Noah-Mav/alice-case/pcb/v3/right_outline.dxf

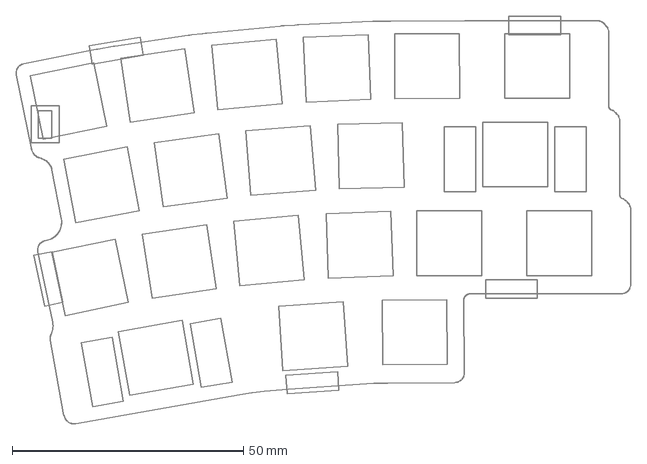
[picture p12: CAD file, 2026-11-01]
pcb/v3/right_outline.dxf
132.9 x 88.2 mm
