Noah-Mav/alice-case/prints/v3/case_body.stl

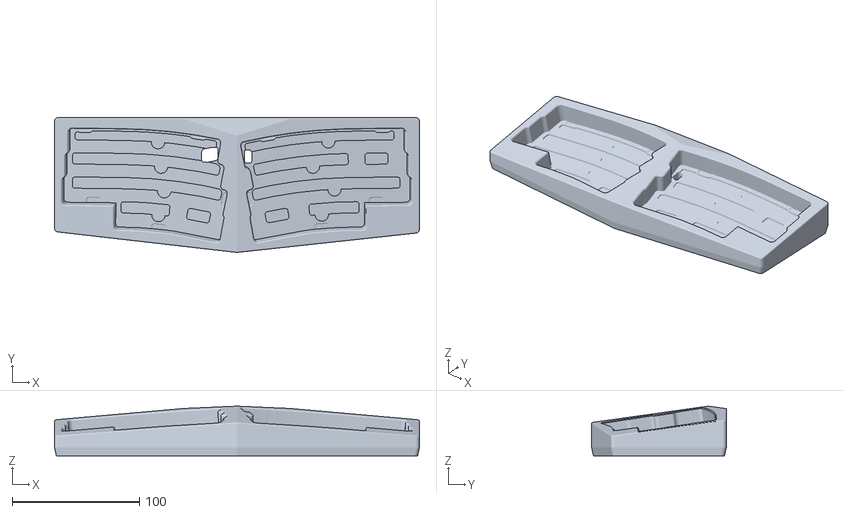
[picture p13: CAD file, 2026-11-01]
prints/v3/case_body.stl
286.5 x 105.9 x 39.1
