Noah-Mav/alice-case/pcb/v3/left_outline.dxf

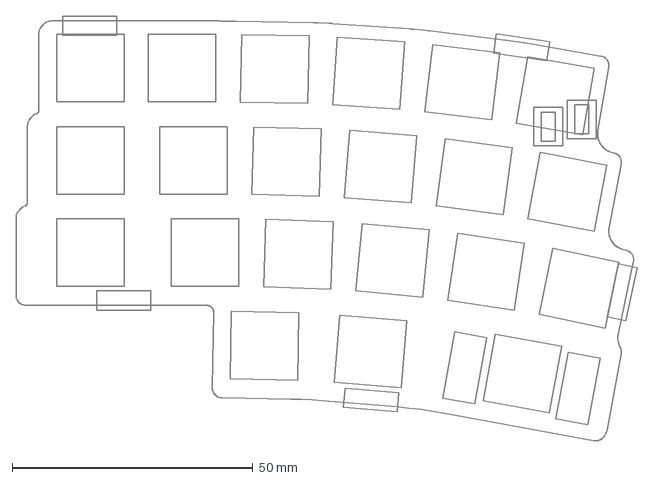
[picture p14: CAD file, 2026-11-01]
pcb/v3/left_outline.dxf
128.9 x 88.2 mm
