Noah-Mav/alice-case/prints/v3/dummy_pcb_right.stl

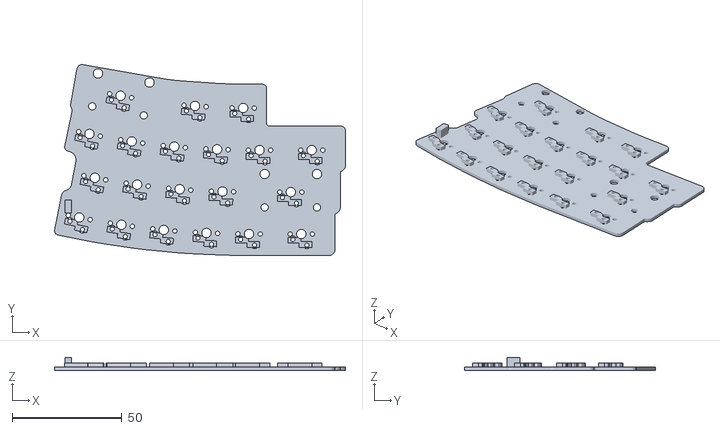
[picture p15: CAD file, 2026-11-01]
prints/v3/dummy_pcb_right.stl
132.9 x 87.2 x 5.85
