Noah-Mav/alice-case/prints/tpu_foot_x4.stl

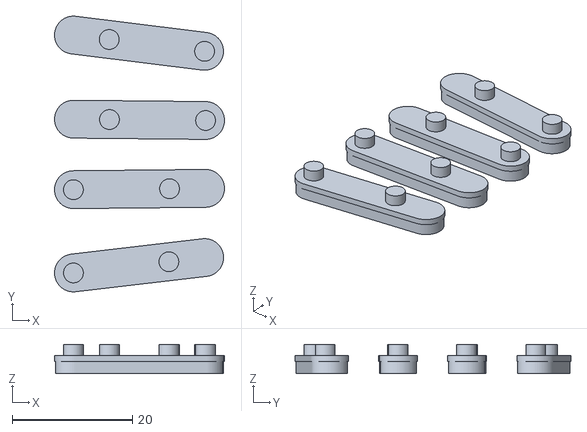
[picture p16: CAD file, 2026-10-18]
prints/tpu_foot_x4.stl
28.3 x 45.9 x 4.90
