Noah-Mav/alice-case/prints/v3/tpu_clip.stl

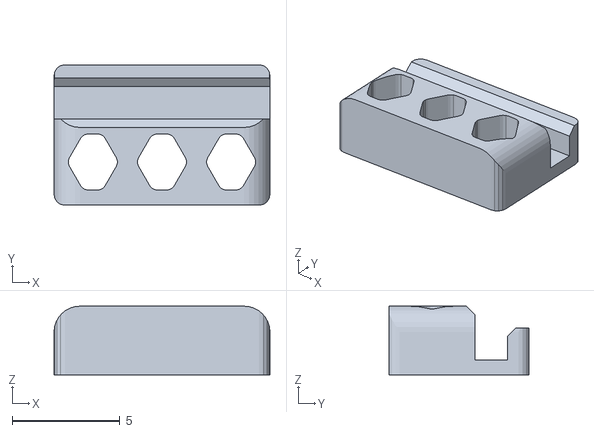
[picture p17: CAD file, 2026-11-01]
prints/v3/tpu_clip.stl
10.0 x 6.50 x 3.18
