Noah-Mav/alice-case/prints/tpu_pcbsnap_x8.stl

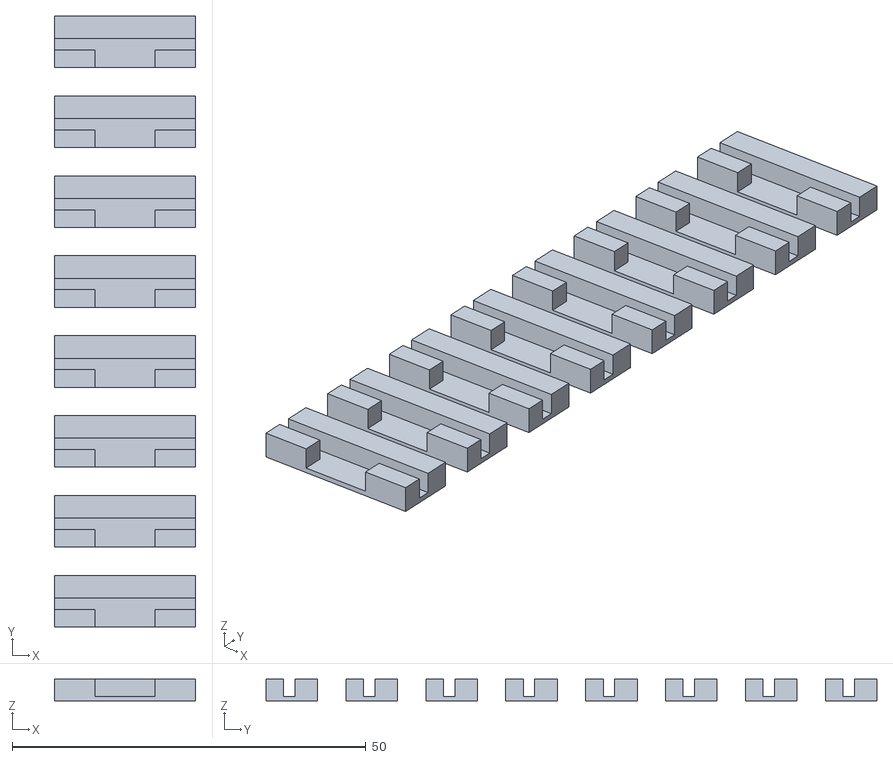
[picture p18: CAD file, 2026-10-18]
prints/tpu_pcbsnap_x8.stl
20.0 x 86.4 x 3.10
