Noah-Mav/alice-case/prints/v3/dummy_pcb_left.stl

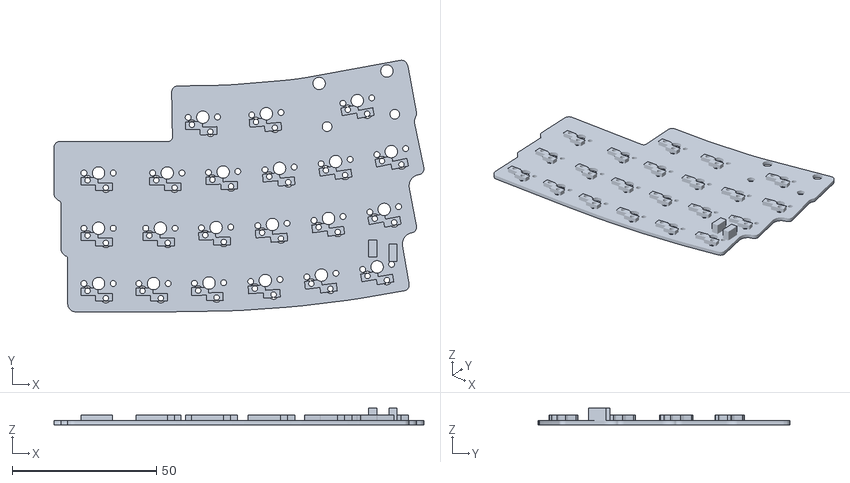
[picture p19: CAD file, 2026-11-01]
prints/v3/dummy_pcb_left.stl
128.2 x 87.2 x 5.85
