Noah-Mav/alice-case/prints/v3/tpu_clip_x10.stl

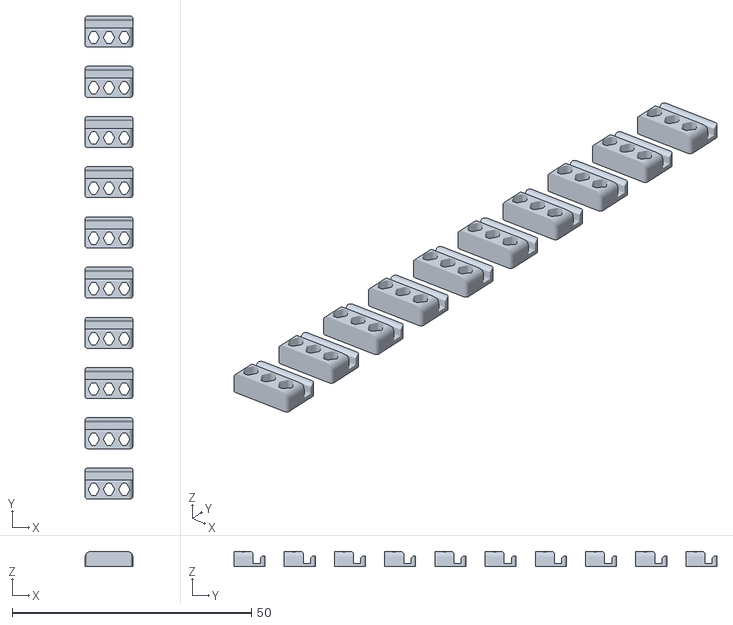
[picture p20: CAD file, 2026-11-01]
prints/v3/tpu_clip_x10.stl
10.0 x 101.0 x 3.18
