Noah-Mav/alice-case/prints/switch_fit_test.stl

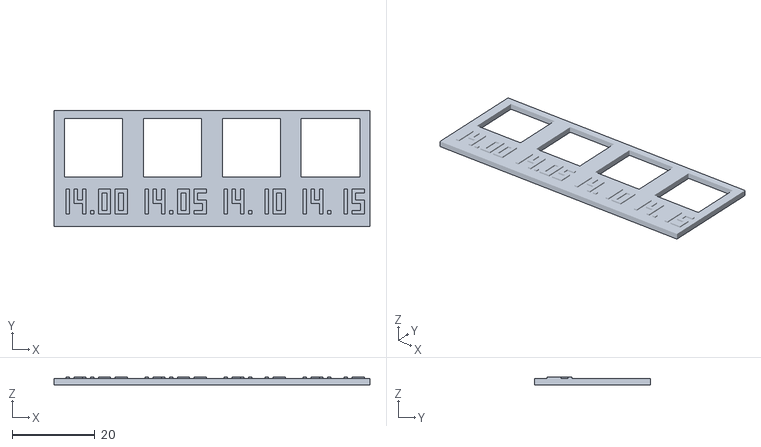
[picture p21: CAD file, 2026-10-18]
prints/switch_fit_test.stl
76.2 x 28.0 x 1.90
