Noah-Mav/alice-case/prints/v3/bottom_panel.stl

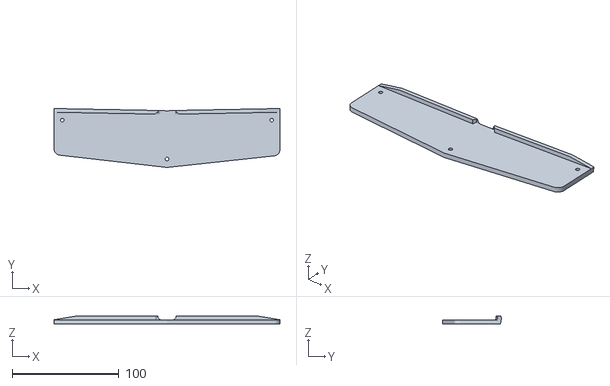
[picture p22: CAD file, 2026-10-31]
prints/v3/bottom_panel.stl
212.2 x 55.2 x 7.60
