Noah-Mav/alice-case/prints/v3/dummy_plate_right.stl

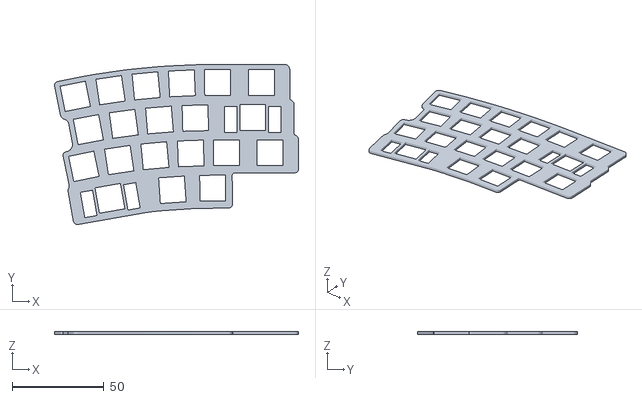
[picture p23: CAD file, 2026-10-31]
prints/v3/dummy_plate_right.stl
132.9 x 87.2 x 1.50
