Noah-Mav/alice-case/prints/dummy_pcb_left.stl

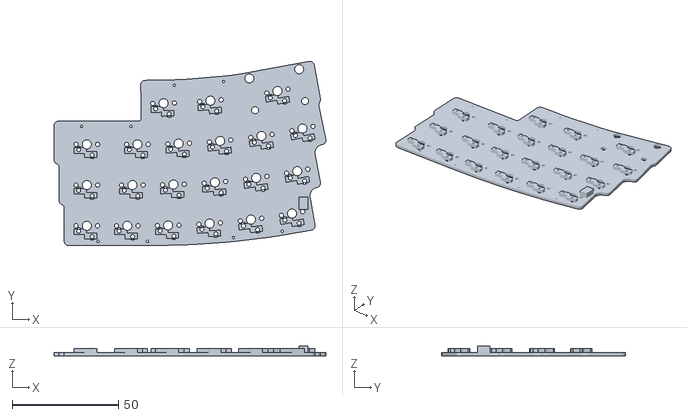
[picture p24: CAD file, 2026-10-18, an earlier design]
prints/dummy_pcb_left.stl
128.0 x 86.7 x 4.55
