Noah-Mav/alice-case/prints/v2/tpu_clip_front.stl

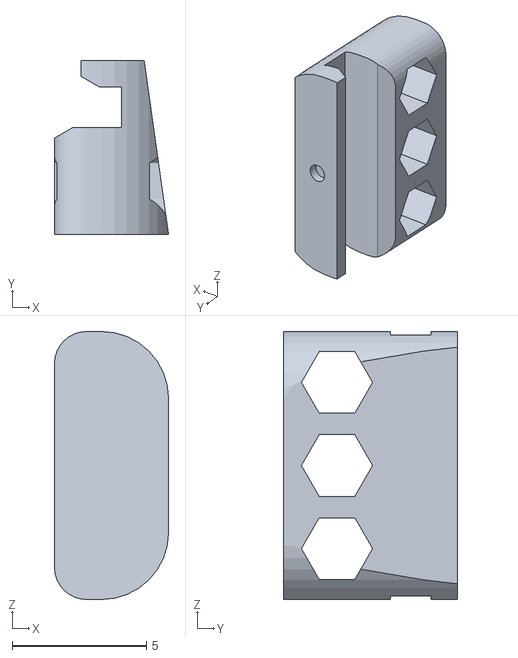
[picture p25: CAD file, 2026-10-24, an earlier design]
prints/v2/tpu_clip_front.stl
4.26 x 6.50 x 10.0
