Noah-Mav/alice-case/prints/dummy_pcb_right.stl

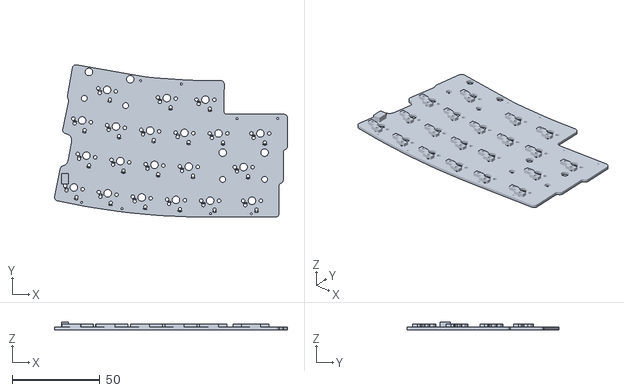
[picture p26: CAD file, 2026-10-18, an earlier design]
prints/dummy_pcb_right.stl
132.6 x 86.8 x 4.55
