Noah-Mav/alice-case/prints/v2/tpu_clip_back_x6.stl

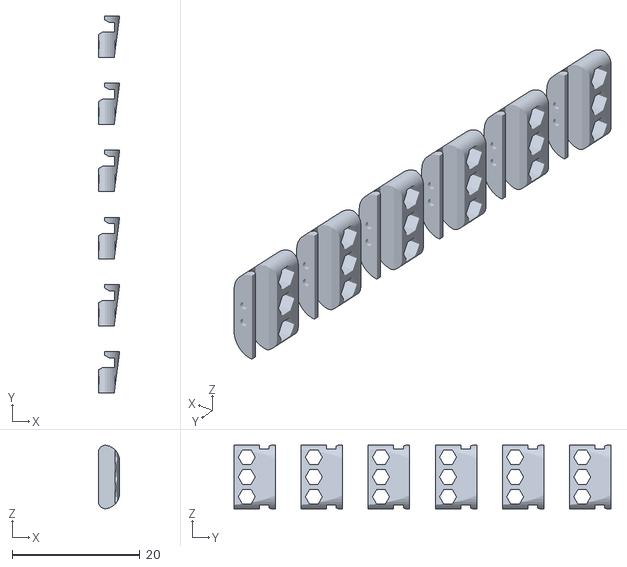
[picture p27: CAD file, 2026-10-24, an earlier design]
prints/v2/tpu_clip_back_x6.stl
3.35 x 59.0 x 9.97
