Noah-Mav/alice-case/(list of files, cad)

Other CAD files:
prints/v3/dummy_plate_left.stl
prints/v3/bottom_panel_flat.stl
prints/bottom_panel.stl
prints/case_body.stl
prints/dummy_plate_left.stl
prints/dummy_plate_right.stl
prints/v2/bottom_panel.stl
prints/v2/case_body.stl
prints/v2/tpu_clip_back.stl
prints/v2/tpu_clip_front_x4.stl
