Noah-Mav/alice-case/(commit log)

2026-10-18 Case for the Alice 40% layout: geometry, Fusion build, checks, exports, docs
2026-10-18 Add print-ready STLs and v9 design updates
    [bottom_panel.stl, case_body.stl, dummy_pcb_left.stl, dummy_pcb_right.stl, dummy_plate_left.stl, dummy_plate_right.stl, switch_fit_test.stl, tpu_foot_x4.stl]
2026-10-18 Dummy PCBs: MX hotswap + stab holes for test builds
    [dummy_pcb_left.stl, dummy_pcb_right.stl]
2026-10-18 Dummy PCBs: add printed hotswap sockets
    [dummy_pcb_left.stl, dummy_pcb_right.stl]
2026-10-24 Case v2: new geometry and Fusion build, TPU clips replace feet and snaps
    Typing 8 deg, tent 5 deg, stepped USB opening, rear peak cut, wider panel,
    bumpon recesses and C-clip recesses. PCB and plate frozen from v1.
    [fusion_build.py, fusion_check_standoffs.py, fusion_checks.py, fusion_export.py, geometry.py, keycaps.py, test_geometry.py]
2026-10-24 Add v2 print files: case body, bottom panel, TPU clip
    [bottom_panel.stl, case_body.stl, tpu_clip.stl, tpu_clip_x10.stl]
2026-10-24 README: design progress v1 to v2, v2 print notes
2026-10-24 TPU clips: front and back variants that bear on the angled pocket walls
    The pocket walls lean about 8.5 degrees opposite ways at the front and back,
    so one clip shape can't seat on both. Each spot gets its own variant, and the
    per-spot fit was checked against the printed clip.
    The new files replace tpu_clip.stl and tpu_clip_x10.stl.
    [tpu_clip.stl, tpu_clip_back.stl, tpu_clip_back_x6.stl, tpu_clip_front.stl, tpu_clip_front_x4.stl, tpu_clip_x10.stl]
2026-10-31 Case v3: square pocket walls, shared PCB/plate edge, one TPU clip
    - Pocket walls square to each half's PCB: one straight wall, floor to
    top, 0.9 mm from the PCB, the plate and every clip (no gap at the back).
    - The PCB and plate share one edge (union of the v1 outlines); keys,
    sockets, stabs and the JST stay where v1 has them.
    - One TPU clip for all 10 spots, printed on its outer face with no
    supports; flat-top hex lattice.
    - Two bottom panels: the v2-style recessed underside and a flat one
    (back border kept).
    - Print files in prints/v3/: body, both panels, clip, dummy PCBs/plates.
    [bottom_panel.stl, bottom_panel_flat.stl, case_body.stl, dummy_pcb_left.stl, dummy_pcb_right.stl, dummy_plate_left.stl, dummy_plate_right.stl, tpu_clip.stl]
2026-11-01 Case v3.1: second left connector for the right-half link, PCB guide
    - The daughterboard has one output, so it is a chain: daughterboard ->
    left PCB -> right PCB. The left PCB gets a second header (vertical
    JST-SH, BM04B-SRSS-TB) beside the first; the left cable cutout is cut
    round both.
    - pcb/v3/: PCB guide (wiring, parts, design rules) and KiCad files
    (board outlines with gasket and connector zones, key positions),
    generated by case/pcb_export.py.
    - Re-exported case_body.stl and dummy_pcb_left.stl.
    [case_body.stl, dummy_pcb_left.stl, left_keys.csv, left_outline.dxf, right_keys.csv, right_outline.dxf]
2026-11-01 Case v3.2: vertical JST headers, squarer TPU gasket with a softer lattice
    - All three PCB headers are vertical JST-SH (BM04B-SRSS-TB): the plug and
    wires drop straight into the cable cutout. The side-entry header faced
    the square web wall and left the wires no room to turn. 10 mm of plug
    space under each header, checked clear in Fusion.
    - Gasket: square plan (the recess now runs past the wall so its R1.5
    corners sit in it), R0.5 end edges, 45 deg lead-ins, and one row of
    three rounded stretched-hex cells with leaning struts and 0.7 skins.
    - Dummy PCBs: fixed a missing socket on the left board; vertical header
    bumps on both.
    - PCB guide: cables, cable room and access with the pane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
    [case_body.stl, dummy_pcb_left.stl, dummy_pcb_right.stl, left_outline.dxf, right_outline.dxf, tpu_clip.stl, tpu_clip_x10.stl]
2026-11-01 Case v3.3: smaller cable holes for the vertical headers
    - Each header gets its own hole through the floor: the plug-and-wires
    space (8 x 4 mm) swept down the tilted PCB normal over its 10 mm,
    + 0.5 mm, R1.5 corners: three holes of 5.9 x 10.3 mm, 172 mm2 in all
    (v3.2: 364 mm2), to keep the switch pockets closed off for the sound.
    - Fusion: plug spaces checked clear of the case (0 interference).
    - Re-exported case_body.stl; PCB outlines regenerated.
    [case_body.stl]
2026-11-01 Case v3.4: the left two cable holes joined into one
    The left PCB's two headers now share one hole through the floor (their
    hull, 12.8 x 11.8 mm, R1.5 corners) instead of two with a thin web
    between them. 191 mm2 of holes in all (v3.1: 364). Fusion: 0
    interference, all checks pass. Re-exported case_body.stl.
    [case_body.stl]
2026-11-01 Print notes v3: pre-print check, supports, hardware, print the flat panel
    Every v3 STL checked watertight (volumes match Fusion). The recessed
    panel's 0.6 mm field starts in the air when printed face down, so the
    flat panel is the one to print (the recessed one is for CNC). Case body:
    supports on the build plate only. Hardware list, fit gaps and a print
    order.
2026-11-01 Print notes: final plate uses 14.0 mm switch cutouts
